jjhamer123/ELE-408-Robot-Art-project/RobotArtLayer_assembly.step

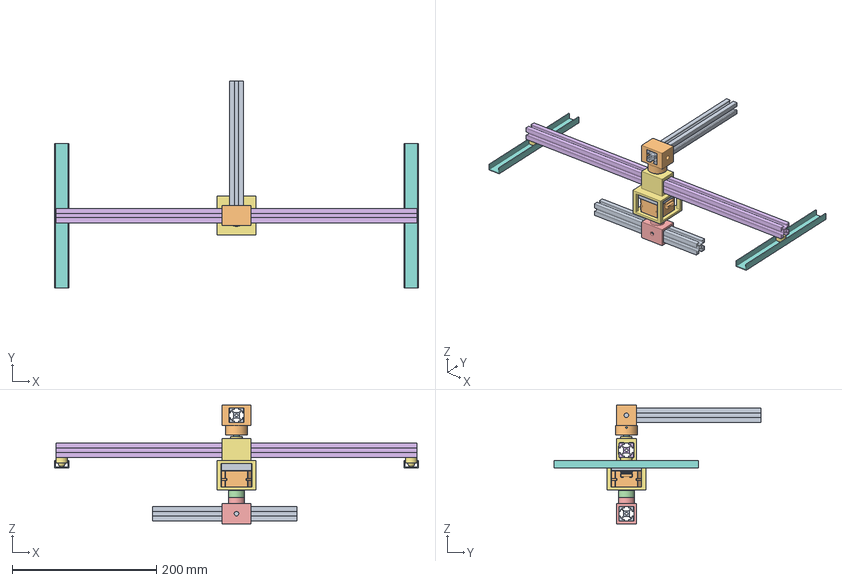
[picture p1: CAD file, 2026-11-11]
RobotArtLayer_assembly.step
504.0 x 286.0 x 164.7 mm
Bar200 2020 200 mm
ClampA_PRINT
5972K91_Steel Ball Bearing
5972K91_Steel Ball Bearing001
5972K91_Steel Ball Bearing002
5972K91_Steel Ball Bearing003
5972K91_Steel Ball Bearing004
5972K91_Steel Ball Bearing005
5972K91_Steel Ball Bearing006
5972K91_Steel Ball Bearing007
5972K91_Steel Ball Bearing008
5972K91_Steel Ball Bearing009
Carriage_MotorCage_PRINT
PivotPin 8 mm steel 24.8 mm long
EncoderBoard stand-in 42x42x10
NEMA17 42x23 Stepper Motor
pan cross head_am_B18.6.7M - M3 x 0.5 x 4 Type I Cross Recessed PHMS --4N
pan cross head_am_B18.6.7M - M3 x 0.5 x 4 Type I Cross Recessed PHMS --4N001
pan cross head_am_B18.6.7M - M3 x 0.5 x 4 Type I Cross Recessed PHMS --4N002
pan cross head_am_B18.6.7M - M3 x 0.5 x 4 Type I Cross Recessed PHMS --4N003
ShaftFlange stand-in 5 mm flange coupler
ClampB_DriveHub_PRINT
NextBar200 reference radius 70 mm
Bar500 2020 500 mm support
BallUnitL stand-in 16 mm body
BallUnitR stand-in 16 mm body
TrackL U-channel 20x10x1.5 200 mm shown
TrackR U-channel 20x10x1.5 200 mm shown
