jjhamer123/ELE-408-Robot-Art-project/robot_art_layer/meshes/bar.stl

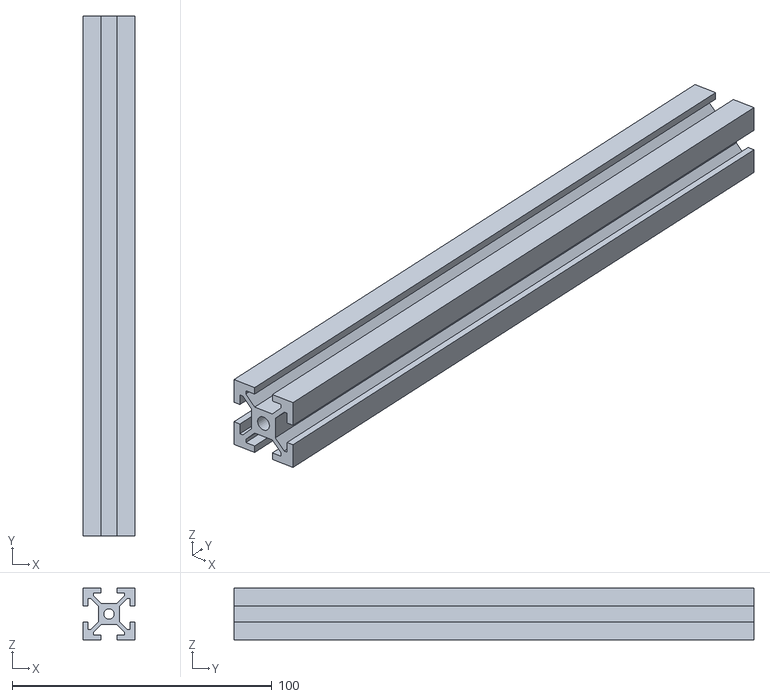
[picture p2: CAD file, 2026-11-11]
robot_art_layer/meshes/bar.stl
20.0 x 200.0 x 20.0
