jjhamer123/ELE-408-Robot-Art-project/robot_art_layer/print/ClampA.step

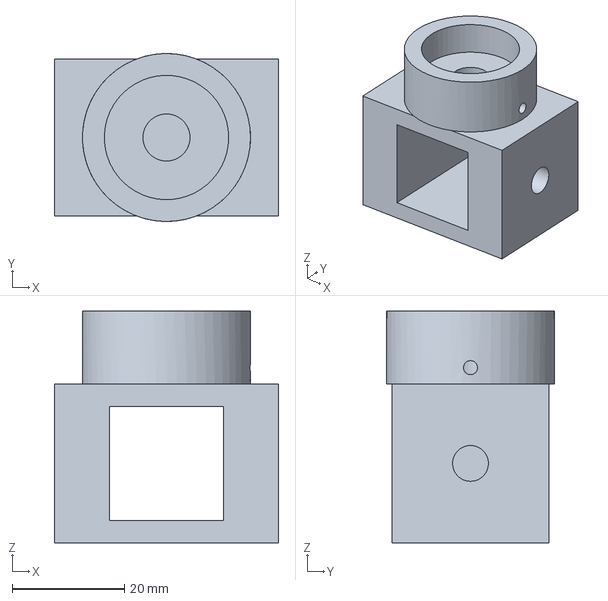
[picture p3: CAD file, 2026-11-11]
robot_art_layer/print/ClampA.step
40.0 x 30.0 x 41.4 mm
