jjhamer123/ELE-408-Robot-Art-project/robot_art_layer/meshes/support.stl

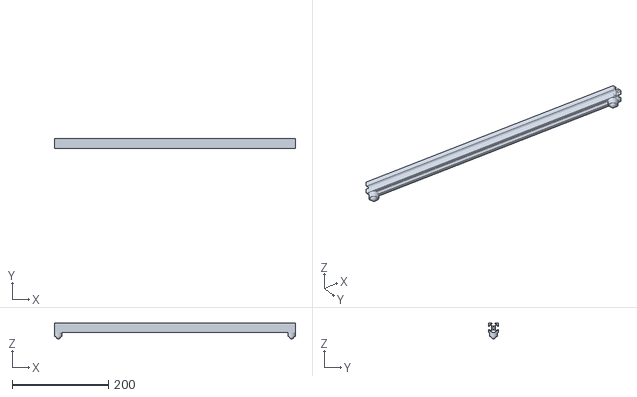
[picture p4: CAD file, 2026-11-11]
robot_art_layer/meshes/support.stl
500.0 x 20.0 x 33.0
