jjhamer123/ELE-408-Robot-Art-project/robot_art_layer/print/Carriage_MotorCage.step

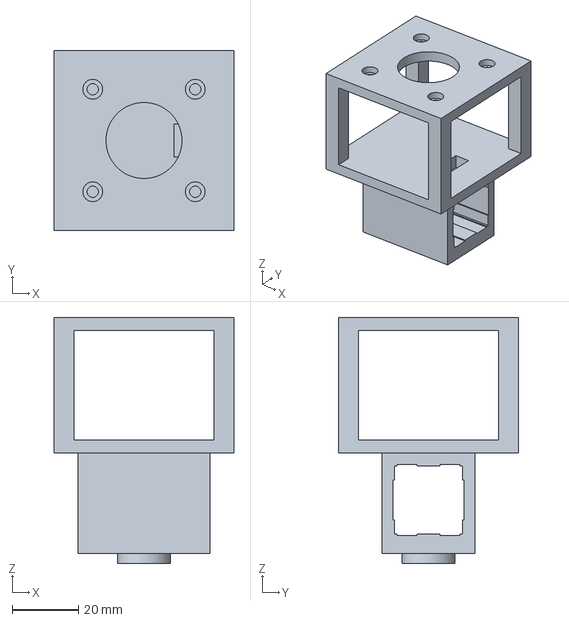
[picture p5: CAD file, 2026-11-11]
robot_art_layer/print/Carriage_MotorCage.step
54.3 x 54.3 x 74.4 mm
