jjhamer123/ELE-408-Robot-Art-project/robot_art_layer/meshes/hub.stl

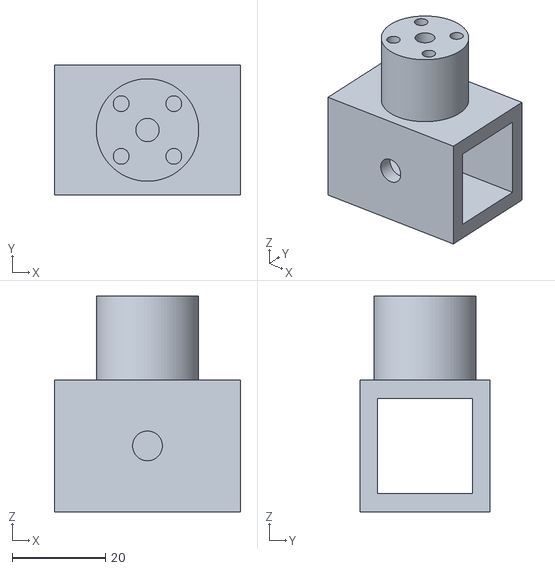
[picture p6: CAD file, 2026-11-11]
robot_art_layer/meshes/hub.stl
40.0 x 28.0 x 46.4
