jjhamer123/ELE-408-Robot-Art-project/robot_art_layer/print/ClampB_DriveHub.step

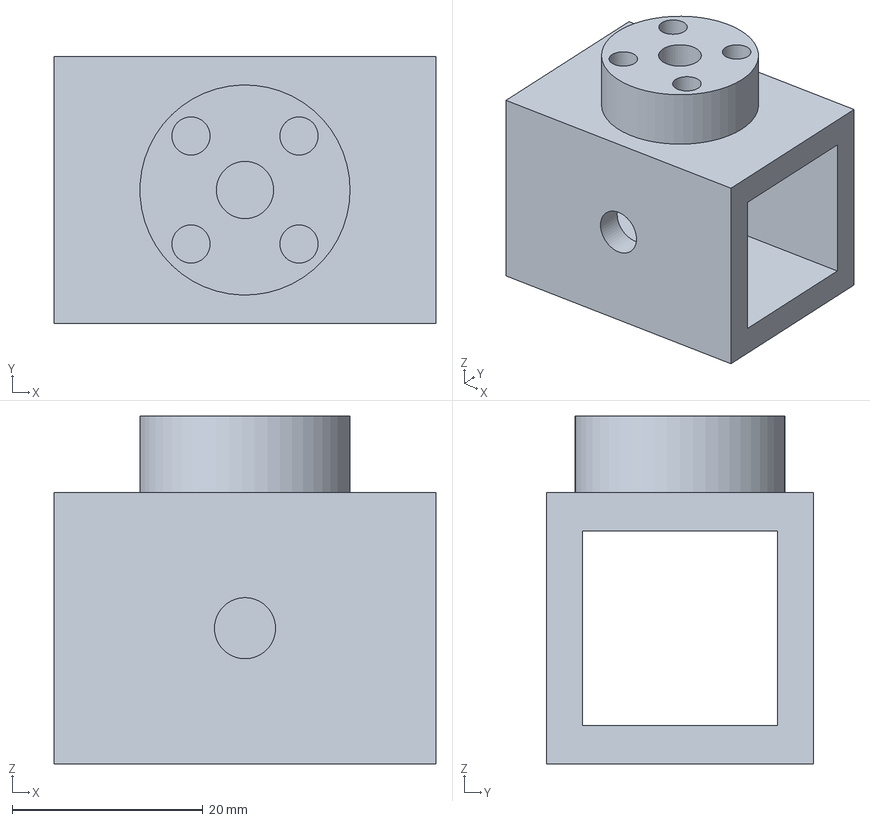
[picture p7: CAD file, 2026-11-11]
robot_art_layer/print/ClampB_DriveHub.step
40.0 x 28.0 x 36.4 mm
