jjhamer123/ELE-408-Robot-Art-project/robot_art_layer/meshes/motor.stl

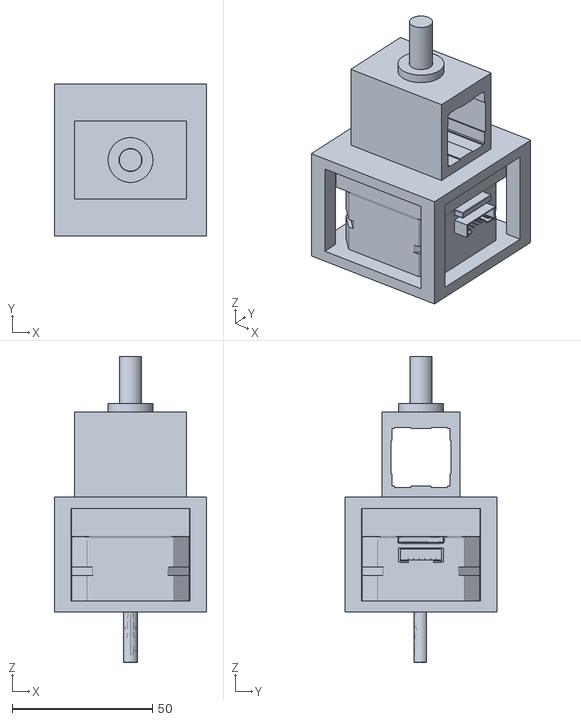
[picture p8: CAD file, 2026-11-11]
robot_art_layer/meshes/motor.stl
54.3 x 54.3 x 109.2
