jjhamer123/ELE-408-Robot-Art-project/robot_art_layer/meshes/clampA.stl

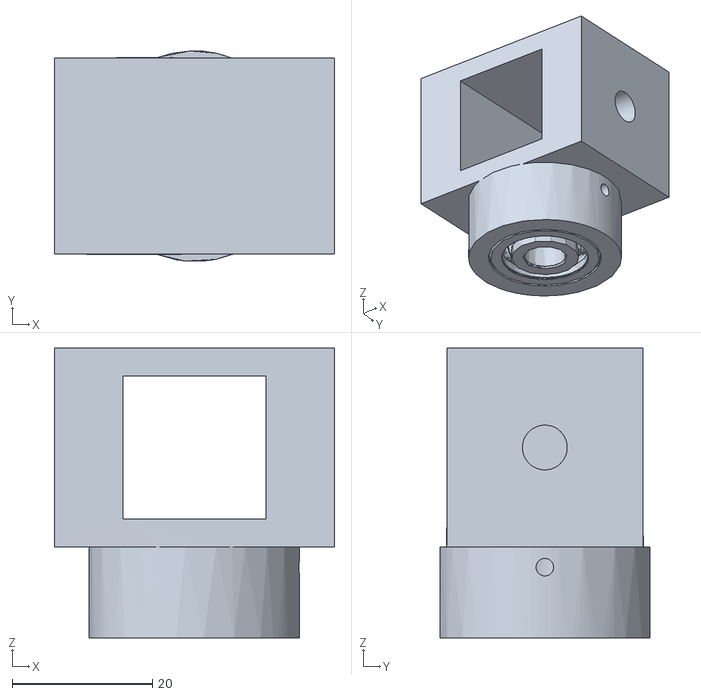
[picture p9: CAD file, 2026-11-11]
robot_art_layer/meshes/clampA.stl
40.0 x 30.0 x 41.4
