jjhamer123/ELE-408-Robot-Art-project/cad/old cad/Layer_finished.FCStd

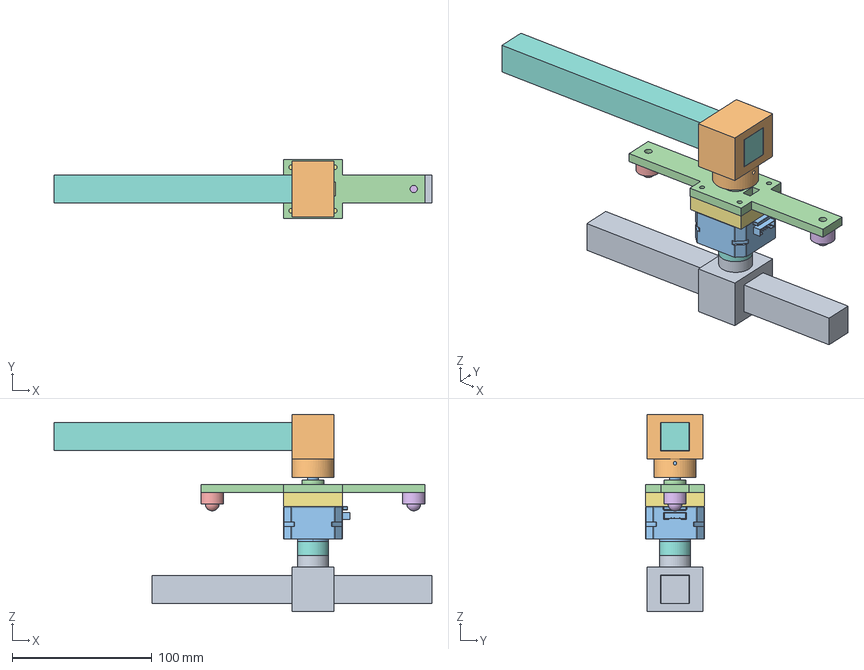
[picture p10: CAD file, 2026-11-11, an earlier design]
cad/old cad/Layer_finished.FCStd
270.0 x 42.3 x 141.0 mm
5972K91_Steel Ball Bearing
5972K91_Steel Ball Bearing001
5972K91_Steel Ball Bearing002
5972K91_Steel Ball Bearing003
5972K91_Steel Ball Bearing004
5972K91_Steel Ball Bearing005
5972K91_Steel Ball Bearing006
5972K91_Steel Ball Bearing007
5972K91_Steel Ball Bearing008
5972K91_Steel Ball Bearing009
NEMA17 42x23 Stepper Motor
pan cross head_am_B18.6.7M - M3 x 0.5 x 4 Type I Cross Recessed PHMS --4N
pan cross head_am_B18.6.7M - M3 x 0.5 x 4 Type I Cross Recessed PHMS --4N001
pan cross head_am_B18.6.7M - M3 x 0.5 x 4 Type I Cross Recessed PHMS --4N002
pan cross head_am_B18.6.7M - M3 x 0.5 x 4 Type I Cross Recessed PHMS --4N003
BarAbove
Bar
ClampA
PivotPin
SupportRail
BallUnitL
BallUnitR
EncoderBoard
ShaftFlange
ClampB
