jjhamer123/ELE-408-Robot-Art-project/(list of files, cad)

Other CAD files:
robot_art_layer/cad/RobotArtLayer.FCStd
robot_art_layer/print/Carriage_MotorCage.stl
robot_art_layer/print/ClampA.stl
robot_art_layer/print/ClampB_DriveHub.stl
