jjhamer123/ELE-408-Robot-Art-project/robot_art_layer/urdf/epicycle_layers.urdf

<?xml version="1.0" ?>
<!-- =================================================================================== -->
<!-- |    This document was autogenerated by xacro from epicycle_layers.urdf.xacro     | -->
<!-- |    EDITING THIS FILE BY HAND IS NOT RECOMMENDED                                 | -->
<!-- =================================================================================== -->
<!--
  ELE408 Robot Art - modular epicycle robot, 3 layers + pen (v3, Nov 2026)
  Generated from the CAD meshes. Units: m, kg, rad.

  Every layer's 500 mm support bar points the SAME way (world X) and never turns:
  each end runs in a U-channel track fixed to the frame (along world Y), and the
  motor carriage slides along the bar. So every motor body keeps facing the same way,
  and joint{i} sets the ABSOLUTE direction of arm i:

      pen (x, y) = sum_i  r_i * (cos joint_i, sin joint_i)        r_i = clampB_i value

  One layer (links in brackets):
    bar{i-1}      200 mm bar the layer hangs from
      clampA{i}   fixed                        [clampA{i}]      clamp A + 608 bearing
      pivot{i}    TOP PIVOT, passive bearing   [motor{i}]       carriage + cage + pin + encoder + NEMA 17
                  layer 1: fixed (hangs from the fixed gantry bar)
                  layers 2+: continuous, <mimic> = -joint{i-1} (the bearing undoes the arm above's turn)
      support{i}  prismatic along X, PASSIVE   [support{i}_bar] 500 mm bar + ball units
                  value = bar centre - carriage centre = -(x of the motor axis)
      joint{i}    BOTTOM PIVOT, motor shaft, continuous, driven     [hub{i}]
      clampB{i}   prismatic, value = radius r_i                     [bar{i}]
    track{i}_L / track{i}_R   fixed to the world (frame), where the ball units roll

  Joints MATLAB must publish on /joint_states: joint1..3, clampB1..3, support1..3.
  pivot2..3 are mimic joints (robot_state_publisher fills them in).

  Radius = rest_radius + clampB value (rest_radius is 0 for ROS, 0.07 for the Godot files).
  Build:   xacro epicycle_layers.urdf.xacro > epicycle_layers.urdf
-->
<robot name="epicycle_layers">
  <!-- carriage (40 mm) can run until it meets a ball unit -->
  <material name="orange">
    <color rgba="0.88 0.54 0.12 1"/>
  </material>
  <material name="alu">
    <color rgba="0.75 0.77 0.80 1"/>
  </material>
  <material name="dark">
    <color rgba="0.25 0.27 0.30 1"/>
  </material>
  <material name="red">
    <color rgba="0.8 0.1 0.1 1"/>
  </material>
  <material name="steel">
    <color rgba="0.55 0.57 0.60 1"/>
  </material>
  <!-- gantry bar height: pen tip lands on z = 0 -->
  <!-- ===== 3 layers hanging from a fixed gantry bar ===== -->
  <link name="world"/>
  <joint name="gantry_fixed" type="fixed">
    <parent link="world"/>
    <child link="bar0"/>
    <origin xyz="0 0 0.5489"/>
  </joint>
  <link name="bar0">
    <visual>
      <geometry>
        <mesh filename="package://robot_art_layer/meshes/bar.stl" scale="0.001 0.001 0.001"/>
      </geometry>
      <material name="alu"/>
    </visual>
    <collision>
      <origin xyz="0 0.086 0"/>
      <geometry>
        <box size="0.02 0.2 0.02"/>
      </geometry>
    </collision>
    <inertial>
      <origin xyz="-0.00000 0.08600 0.00000"/>
      <mass value="0.1000"/>
      <inertia ixx="3.3741e-04" ixy="-8.6845e-21" ixz="-3.3719e-10" iyy="8.1483e-06" iyz="-3.5730e-21" izz="3.3741e-04"/>
    </inertial>
  </link>
  <joint name="clampA1" type="fixed">
    <parent link="bar0"/>
    <child link="clampA1"/>
    <origin xyz="0 0 0"/>
  </joint>
  <link name="clampA1">
    <visual>
      <geometry>
        <mesh filename="package://robot_art_layer/meshes/clampA.stl" scale="0.001 0.001 0.001"/>
      </geometry>
      <material name="orange"/>
    </visual>
    <collision>
      <geometry>
        <box size="0.040 0.028 0.0284"/>
      </geometry>
    </collision>
    <collision>
      <origin xyz="0 0 -0.0207"/>
      <geometry>
        <cylinder length="0.013" radius="0.015"/>
      </geometry>
    </collision>
    <inertial>
      <origin xyz="-0.00011 0.00000 -0.01275"/>
      <mass value="0.0280"/>
      <inertia ixx="6.2275e-06" ixy="-7.0054e-12" ixz="3.6730e-08" iyy="7.7408e-06" iyz="6.4456e-10" izz="4.3962e-06"/>
    </inertial>
  </link>
  <joint name="pivot1" type="fixed">
    <parent link="clampA1"/>
    <child link="motor1"/>
    <origin xyz="0 0 -0.0237"/>
  </joint>
  <link name="motor1">
    <visual>
      <geometry>
        <mesh filename="package://robot_art_layer/meshes/motor.stl" scale="0.001 0.001 0.001"/>
      </geometry>
      <material name="dark"/>
    </visual>
    <collision>
      <origin xyz="0 0 -0.0237"/>
      <geometry>
        <box size="0.040 0.028 0.0304"/>
      </geometry>
    </collision>
    <collision>
      <origin xyz="0 0 -0.0594"/>
      <geometry>
        <box size="0.0543 0.0543 0.041"/>
      </geometry>
    </collision>
    <inertial>
      <origin xyz="0.00009 -0.00000 -0.05783"/>
      <mass value="0.2011"/>
      <inertia ixx="9.6019e-05" ixy="-3.2819e-11" ixz="5.4181e-09" iyy="9.6824e-05" iyz="-4.1809e-09" izz="5.7848e-05"/>
    </inertial>
  </link>
  <joint name="support1" type="prismatic">
    <parent link="motor1"/>
    <child link="support1_bar"/>
    <origin xyz="0 0 0"/>
    <axis xyz="1 0 0"/>
    <!-- value = support bar centre minus carriage centre, along the bar. Passive (effort 0). -->
    <limit effort="0" lower="-0.214" upper="0.214" velocity="1.0"/>
    <dynamics damping="0.0" friction="0.5"/>
  </joint>
  <link name="support1_bar">
    <visual>
      <geometry>
        <mesh filename="package://robot_art_layer/meshes/support.stl" scale="0.001 0.001 0.001"/>
      </geometry>
      <material name="steel"/>
    </visual>
    <collision>
      <origin xyz="0 0 -0.0247"/>
      <geometry>
        <box size="0.50 0.02 0.02"/>
      </geometry>
    </collision>
    <collision>
      <origin xyz="-0.242 0 -0.0387"/>
      <geometry>
        <cylinder length="0.008" radius="0.008"/>
      </geometry>
    </collision>
    <collision>
      <origin xyz="0.242 0 -0.0387"/>
      <geometry>
        <cylinder length="0.008" radius="0.008"/>
      </geometry>
    </collision>
    <inertial>
      <origin xyz="0 0 -0.02559"/>
      <mass value="0.2660"/>
      <inertia ixx="2.4046e-05" ixy="0" ixz="0" iyy="6.1592e-03" iyz="0" izz="6.1560e-03"/>
    </inertial>
  </link>
  <joint name="encoder1_mount" type="fixed">
    <parent link="motor1"/>
    <child link="encoder1"/>
    <origin xyz="0 0 -0.0479"/>
  </joint>
  <link name="encoder1">
    <inertial>
      <mass value="0.001"/>
      <inertia ixx="1e-9" ixy="0" ixz="0" iyy="1e-9" iyz="0" izz="1e-9"/>
    </inertial>
  </link>
  <joint name="joint1" type="continuous">
    <parent link="motor1"/>
    <child link="hub1"/>
    <origin xyz="0 0 -0.0759"/>
    <axis xyz="0 0 1"/>
    <limit effort="0.13" velocity="1.0"/>
    <dynamics damping="0.0"/>
  </joint>
  <link name="hub1">
    <visual>
      <geometry>
        <mesh filename="package://robot_art_layer/meshes/hub.stl" scale="0.001 0.001 0.001"/>
      </geometry>
      <material name="orange"/>
    </visual>
    <collision>
      <origin xyz="0 0 -0.0135"/>
      <geometry>
        <cylinder length="0.018" radius="0.011"/>
      </geometry>
    </collision>
    <collision>
      <origin xyz="0 0 -0.0367"/>
      <geometry>
        <box size="0.040 0.028 0.0284"/>
      </geometry>
    </collision>
    <inertial>
      <origin xyz="-0.00000 0.00004 -0.02232"/>
      <mass value="0.0208"/>
      <inertia ixx="5.9366e-06" ixy="3.9488e-16" ixz="-1.5550e-12" iyy="6.2704e-06" iyz="1.3147e-08" izz="2.9028e-06"/>
    </inertial>
  </link>
  <!-- the next bar slides through clamp B; at joint = 0 the arm points along +X (rpy turns the bar mesh 90 deg) -->
  <joint name="clampB1" type="prismatic">
    <parent link="hub1"/>
    <child link="bar1"/>
    <origin rpy="0 0 1.5707963267948966" xyz="0.0 0 -0.0367"/>
    <axis xyz="0 -1 0"/>
    <limit effort="20" lower="0.03" upper="0.17" velocity="0.05"/>
    <dynamics damping="0.5"/>
  </joint>
  <link name="bar1">
    <visual>
      <geometry>
        <mesh filename="package://robot_art_layer/meshes/bar.stl" scale="0.001 0.001 0.001"/>
      </geometry>
      <material name="alu"/>
    </visual>
    <collision>
      <origin xyz="0 0.086 0"/>
      <geometry>
        <box size="0.02 0.2 0.02"/>
      </geometry>
    </collision>
    <inertial>
      <origin xyz="-0.00000 0.08600 0.00000"/>
      <mass value="0.1000"/>
      <inertia ixx="3.3741e-04" ixy="-8.6845e-21" ixz="-3.3719e-10" iyy="8.1483e-06" iyz="-3.5730e-21" izz="3.3741e-04"/>
    </inertial>
  </link>
  <joint name="track1_L_fixed" type="fixed">
    <parent link="world"/>
    <child link="track1_L"/>
    <origin xyz="-0.242 0 0.4775000000000001"/>
  </joint>
  <link name="track1_L">
    <visual>
      <origin xyz="0 0 -0.00075"/>
      <geometry>
        <box size="0.020 0.03 0.0015"/>
      </geometry>
      <material name="alu"/>
    </visual>
    <visual>
      <origin xyz="-0.00925 0 0.0035"/>
      <geometry>
        <box size="0.0015 0.03 0.010"/>
      </geometry>
      <material name="alu"/>
    </visual>
    <visual>
      <origin xyz="0.00925 0 0.0035"/>
      <geometry>
        <box size="0.0015 0.03 0.010"/>
      </geometry>
      <material name="alu"/>
    </visual>
  </link>
  <joint name="track1_R_fixed" type="fixed">
    <parent link="world"/>
    <child link="track1_R"/>
    <origin xyz="0.242 0 0.4775000000000001"/>
  </joint>
  <link name="track1_R">
    <visual>
      <origin xyz="0 0 -0.00075"/>
      <geometry>
        <box size="0.020 0.03 0.0015"/>
      </geometry>
      <material name="alu"/>
    </visual>
    <visual>
      <origin xyz="-0.00925 0 0.0035"/>
      <geometry>
        <box size="0.0015 0.03 0.010"/>
      </geometry>
      <material name="alu"/>
    </visual>
    <visual>
      <origin xyz="0.00925 0 0.0035"/>
      <geometry>
        <box size="0.0015 0.03 0.010"/>
      </geometry>
      <material name="alu"/>
    </visual>
  </link>
  <joint name="clampA2" type="fixed">
    <parent link="bar1"/>
    <child link="clampA2"/>
    <origin xyz="0 0 0"/>
  </joint>
  <link name="clampA2">
    <visual>
      <geometry>
        <mesh filename="package://robot_art_layer/meshes/clampA.stl" scale="0.001 0.001 0.001"/>
      </geometry>
      <material name="orange"/>
    </visual>
    <collision>
      <geometry>
        <box size="0.040 0.028 0.0284"/>
      </geometry>
    </collision>
    <collision>
      <origin xyz="0 0 -0.0207"/>
      <geometry>
        <cylinder length="0.013" radius="0.015"/>
      </geometry>
    </collision>
    <inertial>
      <origin xyz="-0.00011 0.00000 -0.01275"/>
      <mass value="0.0280"/>
      <inertia ixx="6.2275e-06" ixy="-7.0054e-12" ixz="3.6730e-08" iyy="7.7408e-06" iyz="6.4456e-10" izz="4.3962e-06"/>
    </inertial>
  </link>
  <!-- the bar above lies 90 deg round from the motor's support-bar direction, hence the -90 deg yaw -->
  <joint name="pivot2" type="continuous">
    <parent link="clampA2"/>
    <child link="motor2"/>
    <origin rpy="0 0 -1.5707963267948966" xyz="0 0 -0.0237"/>
    <axis xyz="0 0 1"/>
    <limit effort="0" velocity="10"/>
    <dynamics damping="0.0" friction="0.002"/>
    <mimic joint="joint1" multiplier="-1" offset="0"/>
  </joint>
  <link name="motor2">
    <visual>
      <geometry>
        <mesh filename="package://robot_art_layer/meshes/motor.stl" scale="0.001 0.001 0.001"/>
      </geometry>
      <material name="dark"/>
    </visual>
    <collision>
      <origin xyz="0 0 -0.0237"/>
      <geometry>
        <box size="0.040 0.028 0.0304"/>
      </geometry>
    </collision>
    <collision>
      <origin xyz="0 0 -0.0594"/>
      <geometry>
        <box size="0.0543 0.0543 0.041"/>
      </geometry>
    </collision>
    <inertial>
      <origin xyz="0.00009 -0.00000 -0.05783"/>
      <mass value="0.2011"/>
      <inertia ixx="9.6019e-05" ixy="-3.2819e-11" ixz="5.4181e-09" iyy="9.6824e-05" iyz="-4.1809e-09" izz="5.7848e-05"/>
    </inertial>
  </link>
  <joint name="support2" type="prismatic">
    <parent link="motor2"/>
    <child link="support2_bar"/>
    <origin xyz="0 0 0"/>
    <axis xyz="1 0 0"/>
    <!-- value = support bar centre minus carriage centre, along the bar. Passive (effort 0). -->
    <limit effort="0" lower="-0.214" upper="0.214" velocity="1.0"/>
    <dynamics damping="0.0" friction="0.5"/>
  </joint>
  <link name="support2_bar">
    <visual>
      <geometry>
        <mesh filename="package://robot_art_layer/meshes/support.stl" scale="0.001 0.001 0.001"/>
      </geometry>
      <material name="steel"/>
    </visual>
    <collision>
      <origin xyz="0 0 -0.0247"/>
      <geometry>
        <box size="0.50 0.02 0.02"/>
      </geometry>
    </collision>
    <collision>
      <origin xyz="-0.242 0 -0.0387"/>
      <geometry>
        <cylinder length="0.008" radius="0.008"/>
      </geometry>
    </collision>
    <collision>
      <origin xyz="0.242 0 -0.0387"/>
      <geometry>
        <cylinder length="0.008" radius="0.008"/>
      </geometry>
    </collision>
    <inertial>
      <origin xyz="0 0 -0.02559"/>
      <mass value="0.2660"/>
      <inertia ixx="2.4046e-05" ixy="0" ixz="0" iyy="6.1592e-03" iyz="0" izz="6.1560e-03"/>
    </inertial>
  </link>
  <joint name="encoder2_mount" type="fixed">
    <parent link="motor2"/>
    <child link="encoder2"/>
    <origin xyz="0 0 -0.0479"/>
  </joint>
  <link name="encoder2">
    <inertial>
      <mass value="0.001"/>
      <inertia ixx="1e-9" ixy="0" ixz="0" iyy="1e-9" iyz="0" izz="1e-9"/>
    </inertial>
  </link>
  <joint name="joint2" type="continuous">
    <parent link="motor2"/>
    <child link="hub2"/>
    <origin xyz="0 0 -0.0759"/>
    <axis xyz="0 0 1"/>
    <limit effort="0.13" velocity="1.0"/>
    <dynamics damping="0.0"/>
  </joint>
  <link name="hub2">
    <visual>
      <geometry>
        <mesh filename="package://robot_art_layer/meshes/hub.stl" scale="0.001 0.001 0.001"/>
      </geometry>
      <material name="orange"/>
    </visual>
    <collision>
      <origin xyz="0 0 -0.0135"/>
      <geometry>
        <cylinder length="0.018" radius="0.011"/>
      </geometry>
    </collision>
    <collision>
      <origin xyz="0 0 -0.0367"/>
      <geometry>
        <box size="0.040 0.028 0.0284"/>
      </geometry>
    </collision>
    <inertial>
      <origin xyz="-0.00000 0.00004 -0.02232"/>
      <mass value="0.0208"/>
      <inertia ixx="5.9366e-06" ixy="3.9488e-16" ixz="-1.5550e-12" iyy="6.2704e-06" iyz="1.3147e-08" izz="2.9028e-06"/>
    </inertial>
  </link>
  <!-- the next bar slides through clamp B; at joint = 0 the arm points along +X (rpy turns the bar mesh 90 deg) -->
  <joint name="clampB2" type="prismatic">
    <parent link="hub2"/>
    <child link="bar2"/>
    <origin rpy="0 0 1.5707963267948966" xyz="0.0 0 -0.0367"/>
    <axis xyz="0 -1 0"/>
    <limit effort="20" lower="0.03" upper="0.17" velocity="0.05"/>
    <dynamics damping="0.5"/>
  </joint>
  <link name="bar2">
    <visual>
      <geometry>
        <mesh filename="package://robot_art_layer/meshes/bar.stl" scale="0.001 0.001 0.001"/>
      </geometry>
      <material name="alu"/>
    </visual>
    <collision>
      <origin xyz="0 0.086 0"/>
      <geometry>
        <box size="0.02 0.2 0.02"/>
      </geometry>
    </collision>
    <inertial>
      <origin xyz="-0.00000 0.08600 0.00000"/>
      <mass value="0.1000"/>
      <inertia ixx="3.3741e-04" ixy="-8.6845e-21" ixz="-3.3719e-10" iyy="8.1483e-06" iyz="-3.5730e-21" izz="3.3741e-04"/>
    </inertial>
  </link>
  <joint name="track2_L_fixed" type="fixed">
    <parent link="world"/>
    <child link="track2_L"/>
    <origin xyz="-0.242 0 0.34120000000000006"/>
  </joint>
  <link name="track2_L">
    <visual>
      <origin xyz="0 0 -0.00075"/>
      <geometry>
        <box size="0.020 0.37 0.0015"/>
      </geometry>
      <material name="alu"/>
    </visual>
    <visual>
      <origin xyz="-0.00925 0 0.0035"/>
      <geometry>
        <box size="0.0015 0.37 0.010"/>
      </geometry>
      <material name="alu"/>
    </visual>
    <visual>
      <origin xyz="0.00925 0 0.0035"/>
      <geometry>
        <box size="0.0015 0.37 0.010"/>
      </geometry>
      <material name="alu"/>
    </visual>
  </link>
  <joint name="track2_R_fixed" type="fixed">
    <parent link="world"/>
    <child link="track2_R"/>
    <origin xyz="0.242 0 0.34120000000000006"/>
  </joint>
  <link name="track2_R">
    <visual>
      <origin xyz="0 0 -0.00075"/>
      <geometry>
        <box size="0.020 0.37 0.0015"/>
      </geometry>
      <material name="alu"/>
    </visual>
    <visual>
      <origin xyz="-0.00925 0 0.0035"/>
      <geometry>
        <box size="0.0015 0.37 0.010"/>
      </geometry>
      <material name="alu"/>
    </visual>
    <visual>
      <origin xyz="0.00925 0 0.0035"/>
      <geometry>
        <box size="0.0015 0.37 0.010"/>
      </geometry>
      <material name="alu"/>
    </visual>
  </link>
  <joint name="clampA3" type="fixed">
    <parent link="bar2"/>
    <child link="clampA3"/>
    <origin xyz="0 0 0"/>
  </joint>
  <link name="clampA3">
    <visual>
      <geometry>
        <mesh filename="package://robot_art_layer/meshes/clampA.stl" scale="0.001 0.001 0.001"/>
      </geometry>
      <material name="orange"/>
    </visual>
    <collision>
      <geometry>
        <box size="0.040 0.028 0.0284"/>
      </geometry>
    </collision>
    <collision>
      <origin xyz="0 0 -0.0207"/>
      <geometry>
        <cylinder length="0.013" radius="0.015"/>
      </geometry>
    </collision>
    <inertial>
      <origin xyz="-0.00011 0.00000 -0.01275"/>
      <mass value="0.0280"/>
      <inertia ixx="6.2275e-06" ixy="-7.0054e-12" ixz="3.6730e-08" iyy="7.7408e-06" iyz="6.4456e-10" izz="4.3962e-06"/>
    </inertial>
  </link>
  <!-- the bar above lies 90 deg round from the motor's support-bar direction, hence the -90 deg yaw -->
  <joint name="pivot3" type="continuous">
    <parent link="clampA3"/>
    <child link="motor3"/>
    <origin rpy="0 0 -1.5707963267948966" xyz="0 0 -0.0237"/>
    <axis xyz="0 0 1"/>
    <limit effort="0" velocity="10"/>
    <dynamics damping="0.0" friction="0.002"/>
    <mimic joint="joint2" multiplier="-1" offset="0"/>
  </joint>
  <link name="motor3">
    <visual>
      <geometry>
        <mesh filename="package://robot_art_layer/meshes/motor.stl" scale="0.001 0.001 0.001"/>
      </geometry>
      <material name="dark"/>
    </visual>
    <collision>
      <origin xyz="0 0 -0.0237"/>
      <geometry>
        <box size="0.040 0.028 0.0304"/>
      </geometry>
    </collision>
    <collision>
      <origin xyz="0 0 -0.0594"/>
      <geometry>
        <box size="0.0543 0.0543 0.041"/>
      </geometry>
    </collision>
    <inertial>
      <origin xyz="0.00009 -0.00000 -0.05783"/>
      <mass value="0.2011"/>
      <inertia ixx="9.6019e-05" ixy="-3.2819e-11" ixz="5.4181e-09" iyy="9.6824e-05" iyz="-4.1809e-09" izz="5.7848e-05"/>
    </inertial>
  </link>
  <joint name="support3" type="prismatic">
    <parent link="motor3"/>
    <child link="support3_bar"/>
    <origin xyz="0 0 0"/>
    <axis xyz="1 0 0"/>
    <!-- value = support bar centre minus carriage centre, along the bar. Passive (effort 0). -->
    <limit effort="0" lower="-0.214" upper="0.214" velocity="1.0"/>
    <dynamics damping="0.0" friction="0.5"/>
  </joint>
  <link name="support3_bar">
    <visual>
      <geometry>
        <mesh filename="package://robot_art_layer/meshes/support.stl" scale="0.001 0.001 0.001"/>
      </geometry>
      <material name="steel"/>
    </visual>
    <collision>
      <origin xyz="0 0 -0.0247"/>
      <geometry>
        <box size="0.50 0.02 0.02"/>
      </geometry>
    </collision>
    <collision>
      <origin xyz="-0.242 0 -0.0387"/>
      <geometry>
        <cylinder length="0.008" radius="0.008"/>
      </geometry>
    </collision>
    <collision>
      <origin xyz="0.242 0 -0.0387"/>
      <geometry>
        <cylinder length="0.008" radius="0.008"/>
      </geometry>
    </collision>
    <inertial>
      <origin xyz="0 0 -0.02559"/>
      <mass value="0.2660"/>
      <inertia ixx="2.4046e-05" ixy="0" ixz="0" iyy="6.1592e-03" iyz="0" izz="6.1560e-03"/>
    </inertial>
  </link>
  <joint name="encoder3_mount" type="fixed">
    <parent link="motor3"/>
    <child link="encoder3"/>
    <origin xyz="0 0 -0.0479"/>
  </joint>
  <link name="encoder3">
    <inertial>
      <mass value="0.001"/>
      <inertia ixx="1e-9" ixy="0" ixz="0" iyy="1e-9" iyz="0" izz="1e-9"/>
    </inertial>
  </link>
  <joint name="joint3" type="continuous">
    <parent link="motor3"/>
    <child link="hub3"/>
    <origin xyz="0 0 -0.0759"/>
    <axis xyz="0 0 1"/>
    <limit effort="0.13" velocity="1.0"/>
    <dynamics damping="0.0"/>
  </joint>
  <link name="hub3">
    <visual>
      <geometry>
        <mesh filename="package://robot_art_layer/meshes/hub.stl" scale="0.001 0.001 0.001"/>
      </geometry>
      <material name="orange"/>
    </visual>
    <collision>
      <origin xyz="0 0 -0.0135"/>
      <geometry>
        <cylinder length="0.018" radius="0.011"/>
      </geometry>
    </collision>
    <collision>
      <origin xyz="0 0 -0.0367"/>
      <geometry>
        <box size="0.040 0.028 0.0284"/>
      </geometry>
    </collision>
    <inertial>
      <origin xyz="-0.00000 0.00004 -0.02232"/>
      <mass value="0.0208"/>
      <inertia ixx="5.9366e-06" ixy="3.9488e-16" ixz="-1.5550e-12" iyy="6.2704e-06" iyz="1.3147e-08" izz="2.9028e-06"/>
    </inertial>
  </link>
  <!-- the next bar slides through clamp B; at joint = 0 the arm points along +X (rpy turns the bar mesh 90 deg) -->
  <joint name="clampB3" type="prismatic">
    <parent link="hub3"/>
    <child link="bar3"/>
    <origin rpy="0 0 1.5707963267948966" xyz="0.0 0 -0.0367"/>
    <axis xyz="0 -1 0"/>
    <limit effort="20" lower="0.03" upper="0.17" velocity="0.05"/>
    <dynamics damping="0.5"/>
  </joint>
  <link name="bar3">
    <visual>
      <geometry>
        <mesh filename="package://robot_art_layer/meshes/bar.stl" scale="0.001 0.001 0.001"/>
      </geometry>
      <material name="alu"/>
    </visual>
    <collision>
      <origin xyz="0 0.086 0"/>
      <geometry>
        <box size="0.02 0.2 0.02"/>
      </geometry>
    </collision>
    <inertial>
      <origin xyz="-0.00000 0.08600 0.00000"/>
      <mass value="0.1000"/>
      <inertia ixx="3.3741e-04" ixy="-8.6845e-21" ixz="-3.3719e-10" iyy="8.1483e-06" iyz="-3.5730e-21" izz="3.3741e-04"/>
    </inertial>
  </link>
  <joint name="track3_L_fixed" type="fixed">
    <parent link="world"/>
    <child link="track3_L"/>
    <origin xyz="-0.242 0 0.20490000000000005"/>
  </joint>
  <link name="track3_L">
    <visual>
      <origin xyz="0 0 -0.00075"/>
      <geometry>
        <box size="0.020 0.7100000000000001 0.0015"/>
      </geometry>
      <material name="alu"/>
    </visual>
    <visual>
      <origin xyz="-0.00925 0 0.0035"/>
      <geometry>
        <box size="0.0015 0.7100000000000001 0.010"/>
      </geometry>
      <material name="alu"/>
    </visual>
    <visual>
      <origin xyz="0.00925 0 0.0035"/>
      <geometry>
        <box size="0.0015 0.7100000000000001 0.010"/>
      </geometry>
      <material name="alu"/>
    </visual>
  </link>
  <joint name="track3_R_fixed" type="fixed">
    <parent link="world"/>
    <child link="track3_R"/>
    <origin xyz="0.242 0 0.20490000000000005"/>
  </joint>
  <link name="track3_R">
    <visual>
      <origin xyz="0 0 -0.00075"/>
      <geometry>
        <box size="0.020 0.7100000000000001 0.0015"/>
      </geometry>
      <material name="alu"/>
    </visual>
    <visual>
      <origin xyz="-0.00925 0 0.0035"/>
      <geometry>
        <box size="0.0015 0.7100000000000001 0.010"/>
      </geometry>
      <material name="alu"/>
    </visual>
    <visual>
      <origin xyz="0.00925 0 0.0035"/>
      <geometry>
        <box size="0.0015 0.7100000000000001 0.010"/>
      </geometry>
      <material name="alu"/>
    </visual>
  </link>
  <!-- pen at the end of the last bar (where a 4th layer's clamp A would go) -->
  <joint name="pen_mount" type="fixed">
    <parent link="bar3"/>
    <child link="pen"/>
    <origin xyz="0 0 -0.010"/>
  </joint>
  <link name="pen">
    <visual>
      <origin xyz="0 0 -0.015"/>
      <geometry>
        <box size="0.03 0.03 0.03"/>
      </geometry>
      <material name="orange"/>
    </visual>
    <visual>
      <origin xyz="0 0 -0.080"/>
      <geometry>
        <cylinder length="0.100" radius="0.005"/>
      </geometry>
      <material name="red"/>
    </visual>
    <collision>
      <origin xyz="0 0 -0.080"/>
      <geometry>
        <cylinder length="0.100" radius="0.005"/>
      </geometry>
    </collision>
    <inertial>
      <origin xyz="0 0 -0.04"/>
      <mass value="0.03"/>
      <inertia ixx="2e-5" ixy="0" ixz="0" iyy="2e-5" iyz="0" izz="1e-6"/>
    </inertial>
  </link>
  <joint name="pen_tip_mount" type="fixed">
    <parent link="pen"/>
    <child link="pen_tip"/>
    <origin xyz="0 0 -0.130"/>
  </joint>
  <link name="pen_tip">
    <inertial>
      <mass value="0.001"/>
      <inertia ixx="1e-9" ixy="0" ixz="0" iyy="1e-9" iyz="0" izz="1e-9"/>
    </inertial>
  </link>
</robot>
