jjhamer123/ELE-408-Robot-Art-project/(commit log)

2026-11-03 added all the things needed to add
    [CPMOVER6.urdf, plugin.cfg]
2026-11-10 slightly broken but files are here
    [CPMOVER6.urdf, plugin.cfg]
2026-11-11 Robot Art layer picker on ImportRobot + addon fixes
    [Carriage_MotorCage.step, Carriage_MotorCage.stl, ClampA.step, ClampA.stl, ClampB_DriveHub.step, ClampB_DriveHub.stl, Layer_finished.FCStd, RobotArtLayer.FCStd]
